EmanuelDecima/Fuente-Variable-con-Microcontrolador-/Doc/Imagenes/PCB_Front.png

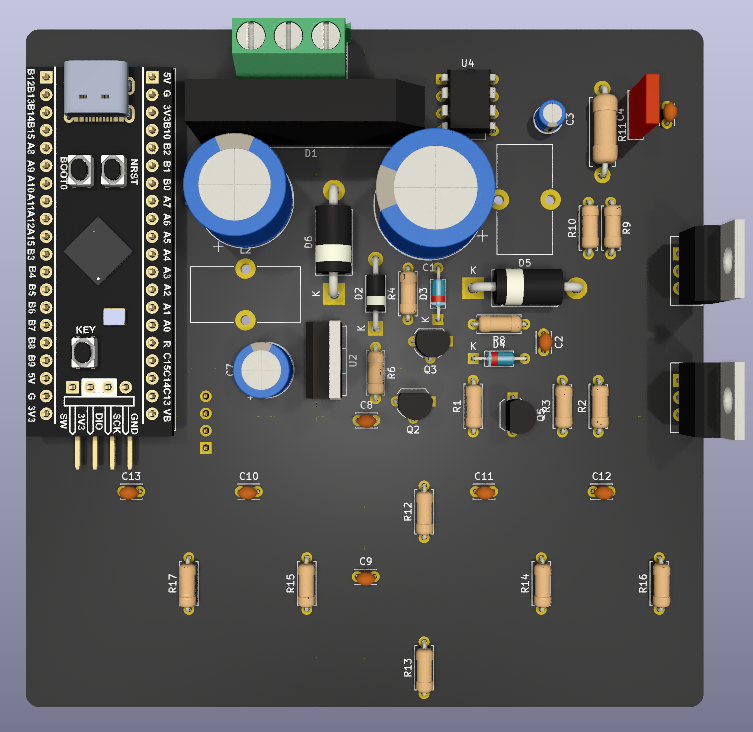
Doc/Imagenes/PCB_Front.png
