EmanuelDecima/Fuente-Variable-con-Microcontrolador-/Doc/Imagenes/PCB_Back.png

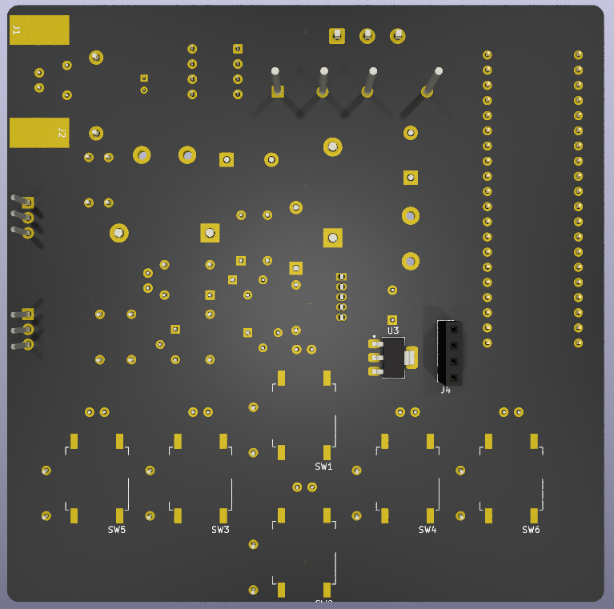
Doc/Imagenes/PCB_Back.png
