EmanuelDecima/Fuente-Variable-con-Microcontrolador-/Doc/Esquemas/FusibleElectronico-S-valores.pdf

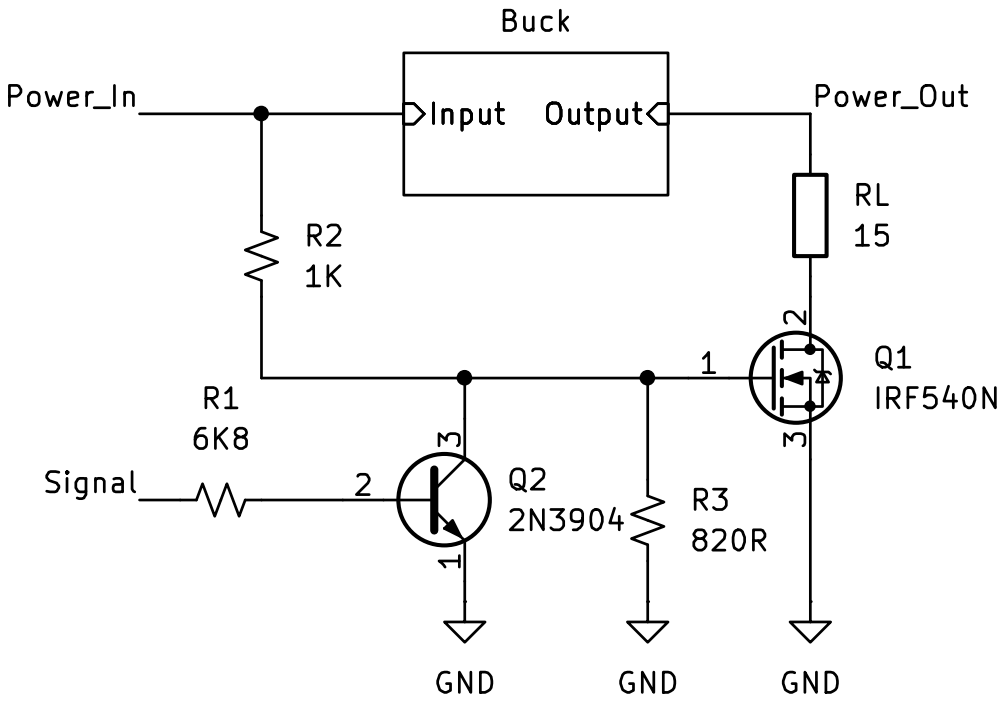
[picture p7: page 1]

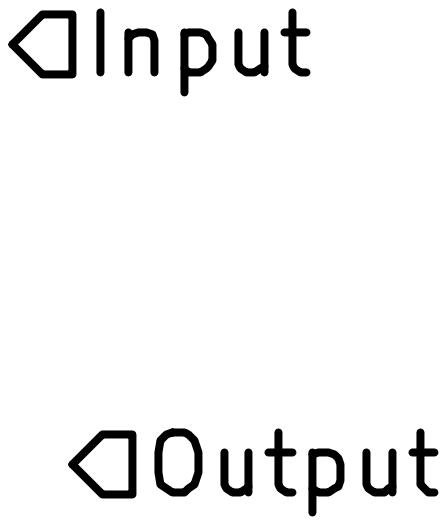
[picture p8: page 2]
