EmanuelDecima/Fuente-Variable-con-Microcontrolador-/Doc/Esquemas/Esquematico.pdf

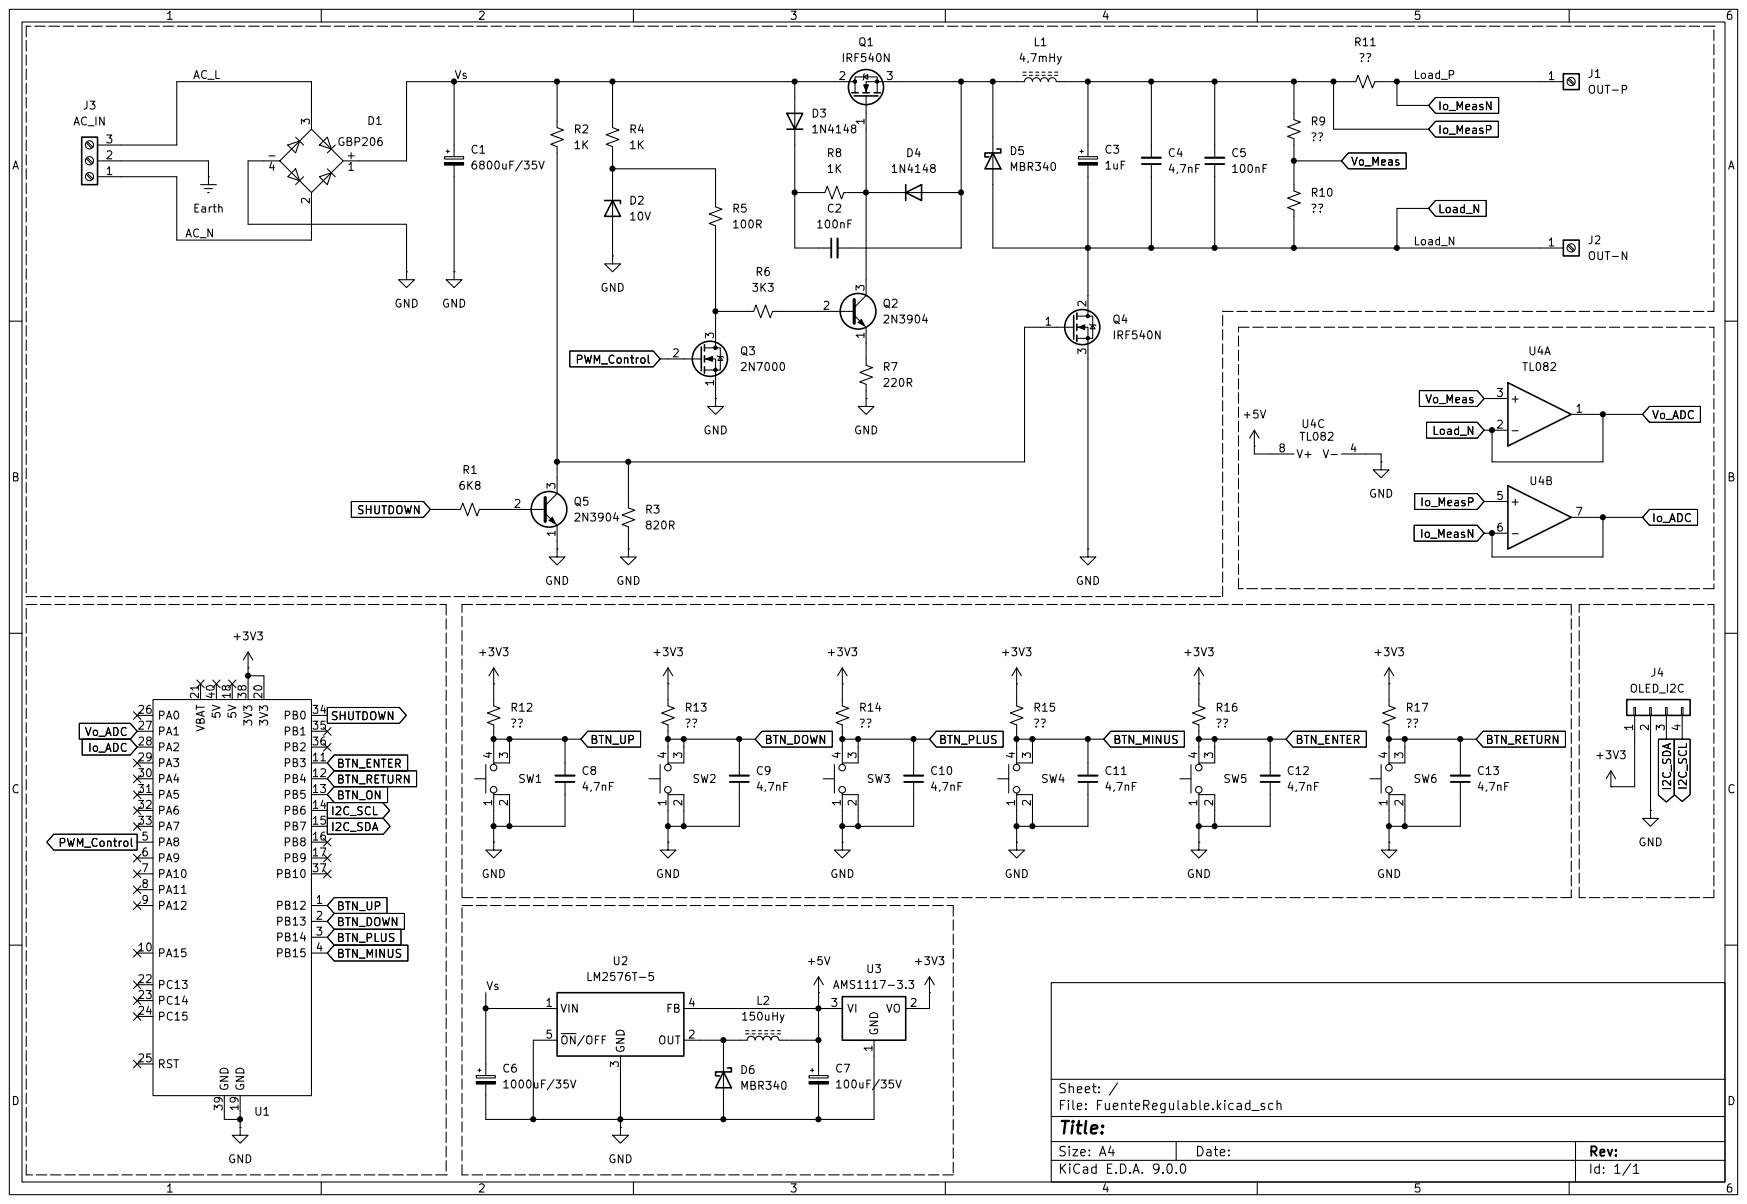
[picture p9: page 1]
