EmanuelDecima/Fuente-Variable-con-Microcontrolador-/Doc/Esquemas/EsquematicoV2.pdf

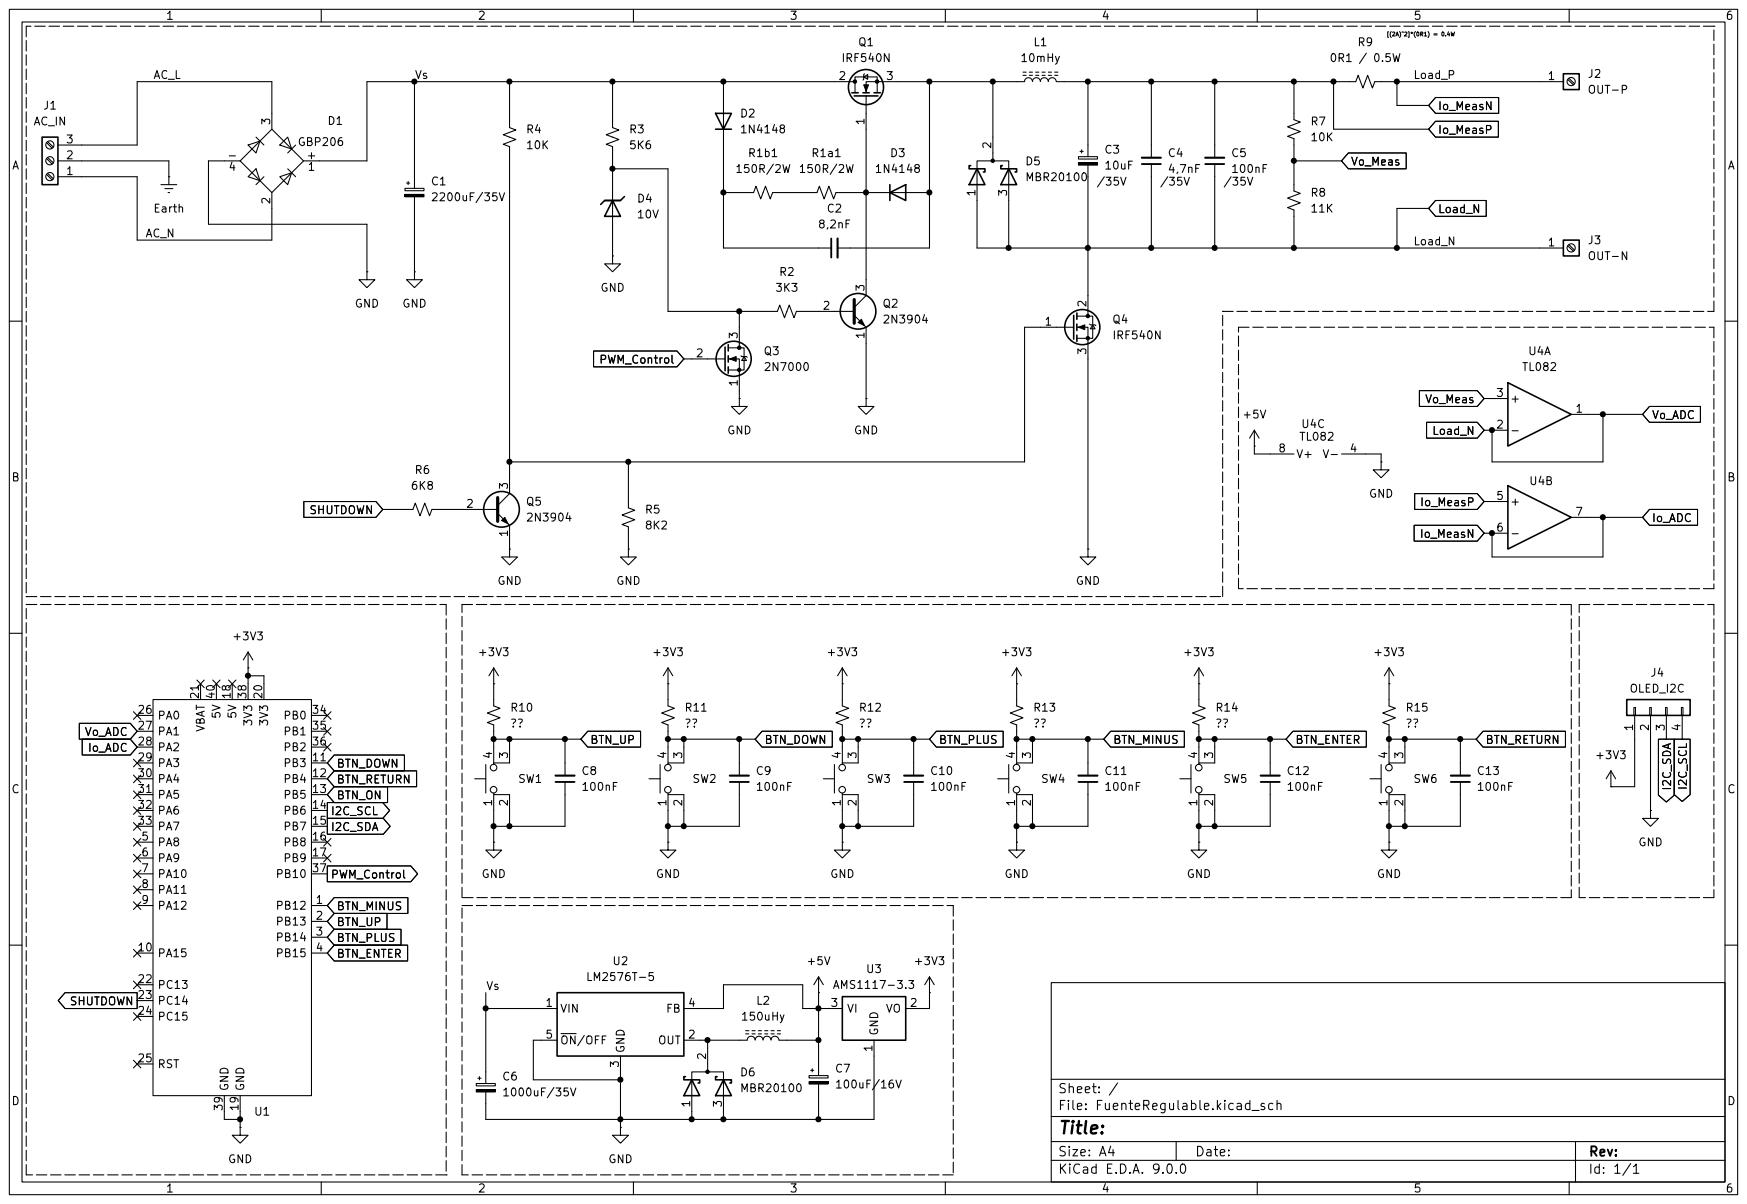
[picture p10: page 1]
