EmanuelDecima/Fuente-Variable-con-Microcontrolador-/Simulaciones/FusibleElectronico.asc

M1: nmos; AON6162
M2: nmos; 2N7002
R1: res; 6.8k
R2: res; 10k
R3: res; 8.2k
RL: res; 15
V1: voltage; SINE(31.84 3.18 100)
V2: voltage; PULSE(0 3.3 50m 1n 1n 100m 200m)
Named nets: 0
.tran 1
