EmanuelDecima/Fuente-Variable-con-Microcontrolador-/Simulaciones/PuenteDiodos.asc

C1: cap; 6800µ
D1: diode
D2: diode
D3: diode
D4: diode
RL: res; 16.92
V1: signal; SINE(0 33.84 50)
V2: voltage; 2
Named nets: 0, Salida
.tran 0 100m 10m
