EmanuelDecima/Fuente-Variable-con-Microcontrolador-/FuenteRegulable/FuenteRegulable.kicad_pcb

## KiCad design FuenteRegulable/FuenteRegulable.kicad_pcb (2025-11-13)

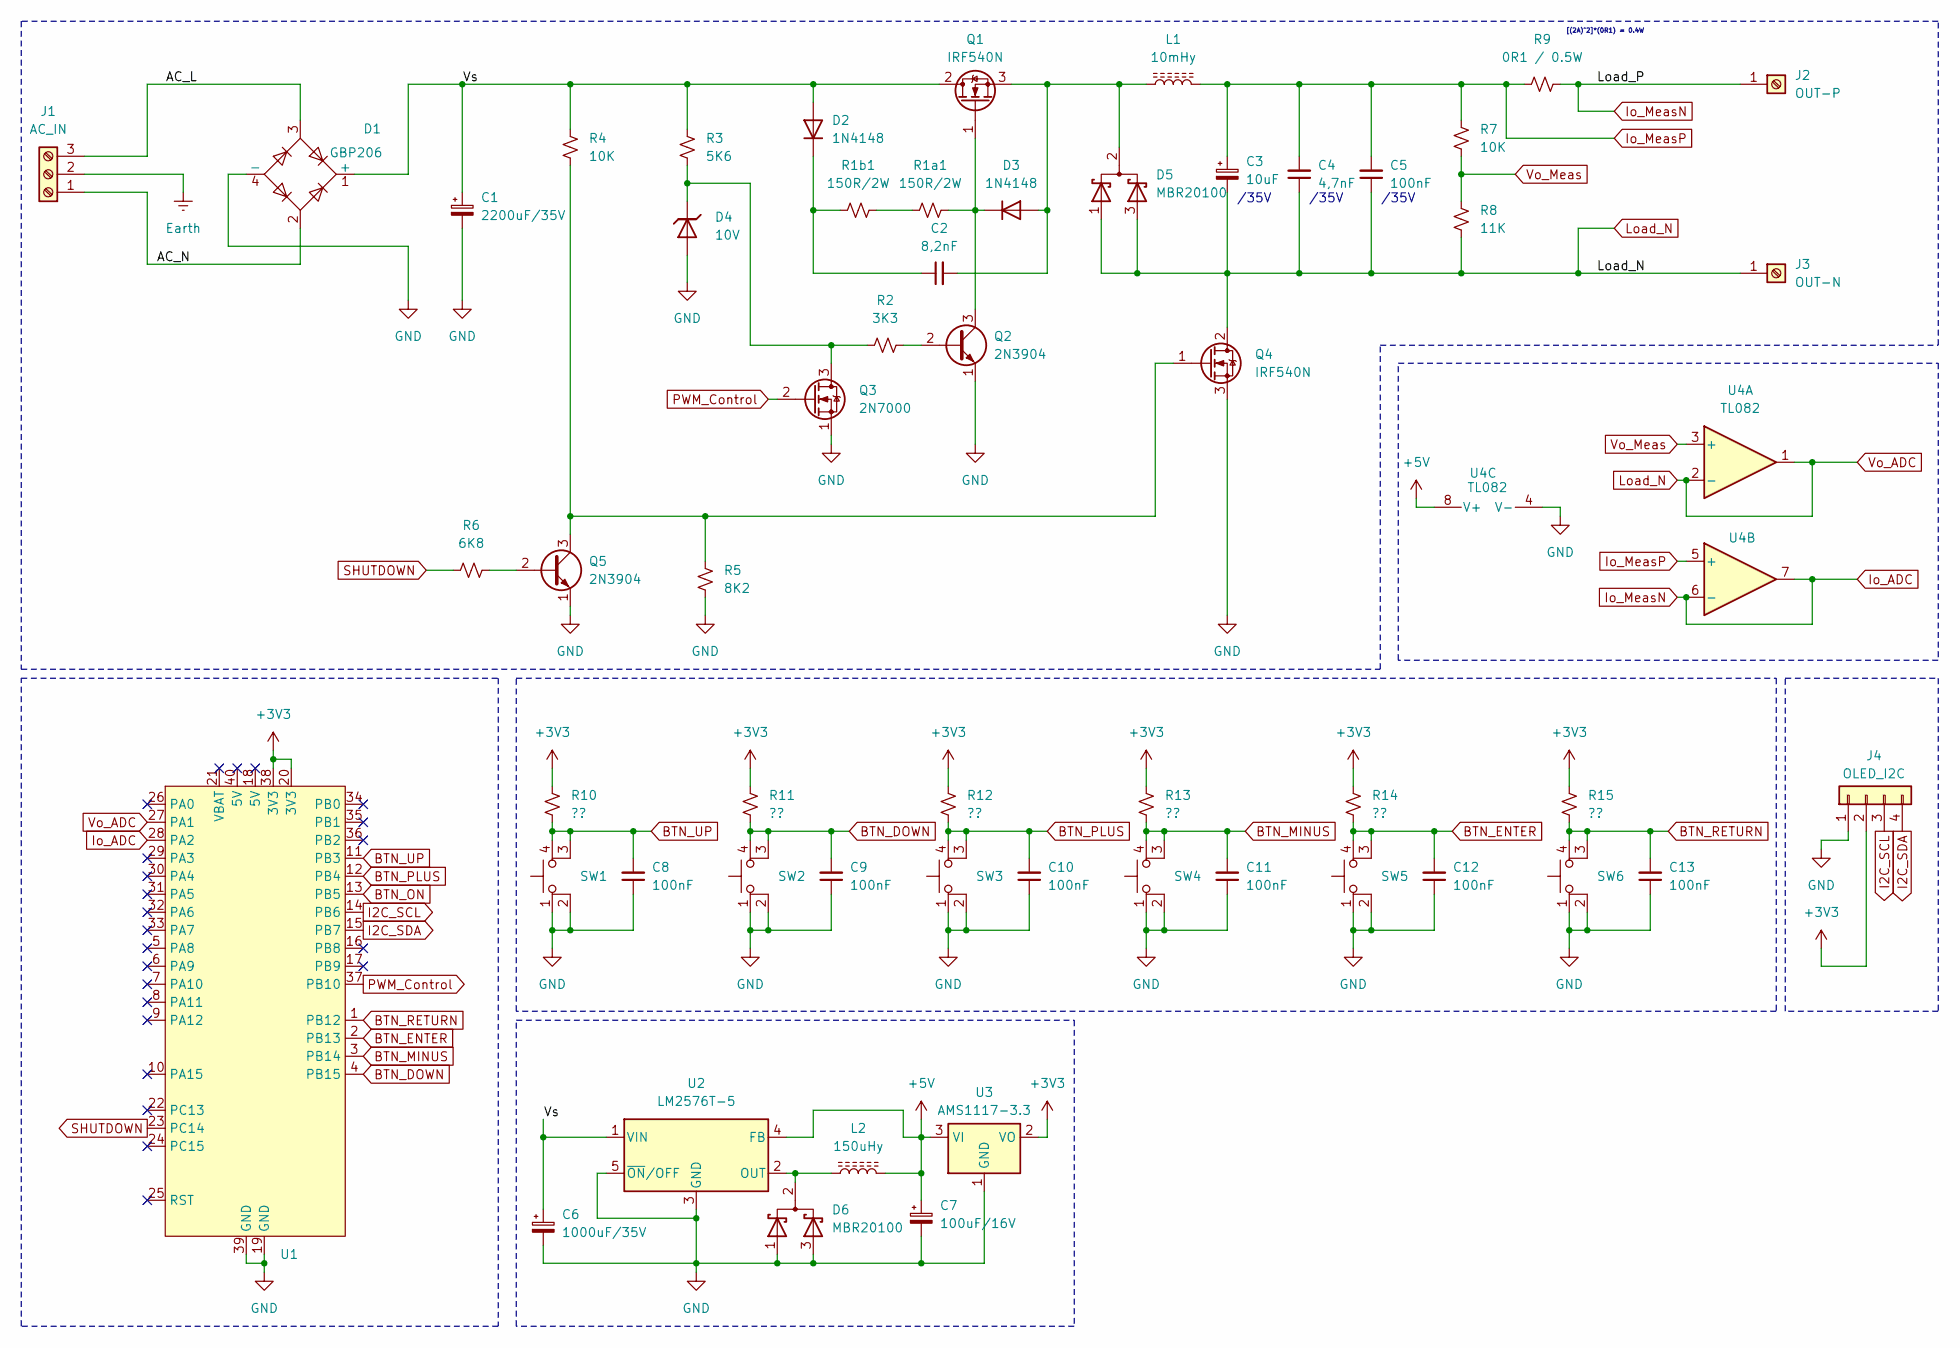
[picture p11: schematic FuenteRegulable.kicad_sch]

Parts:
C1: 2200uF/35V; CP_Radial_D16.0mm_P7.50mm
C2: 8,2nF; C_Disc_D3.0mm_W2.0mm_P2.50mm
C3: 10uF; CP_Radial_D4.0mm_P2.00mm
C4: 4,7nF; C_Rect_L7.0mm_W2.0mm_P5.00mm
C5, C8, C9, C10, C11, C12, C13: 100nF; C_Disc_D3.0mm_W2.0mm_P2.50mm
C6: 1000uF/35V; CP_Radial_D14.0mm_P7.50mm
C7: 100uF/16V; CP_Radial_D8.0mm_P5.00mm
D1: GBP206; Diode_Bridge_32.0x5.6x17.0mm_P10.0mm_P7.5mm
D2, D3: 1N4148; D_DO-35_SOD27_P7.62mm_Horizontal
D4: 10V; D_DO-41_SOD81_P10.16mm_Horizontal
D5, D6: MBR20100; TO-220-3_Horizontal_TabDown
J1: AC_IN; TerminalBlock_Phoenix_MKDS-1,5-3-5.08_1x03_P5.08mm_Horizont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
J2: OUT-P; SolderWirePad_1x01_SMD_5x10mm
J3: OUT-N; SolderWirePad_1x01_SMD_5x10mm
J4: OLED_I2C; PinSocket_1x04_P2.54mm_Vertical
L1: 10mHy; L_Toroid_Vertical_L16.0mm_W8.0mm_P7.62mm
L2: 150uHy; L_Toroid_Vertical_L16.0mm_W8.0mm_P7.62mm
Q1, Q4: IRF540N; TO-220-3_Vertical
Q2, Q5: 2N3904; TO-92_Wide
Q3: 2N7000; TO-92_Wide
R1a1, R1b1: 150R/2W; R_Axial_DIN0614_L14.3mm_D5.7mm_P15.24mm_Horizontal
R2: 3K3; R_Axial_DIN0207_L6.3mm_D2.5mm_P7.62mm_Horizontal
R3: 5K6; R_Axial_DIN0207_L6.3mm_D2.5mm_P7.62mm_Horizontal
R4, R7: 10K; R_Axial_DIN0207_L6.3mm_D2.5mm_P7.62mm_Horizontal
R5: 8K2; R_Axial_DIN0207_L6.3mm_D2.5mm_P7.62mm_Horizontal
R6: 6K8; R_Axial_DIN0207_L6.3mm_D2.5mm_P7.62mm_Horizontal
R8: 11K; R_Axial_DIN0207_L6.3mm_D2.5mm_P7.62mm_Horizontal
R9: 0R1 / 0.5W; R_Axial_DIN0411_L9.9mm_D3.6mm_P12.70mm_Horizontal
R10, R11, R12, R13, R14, R15: ??; R_Axial_DIN0207_L6.3mm_D2.5mm_P7.62mm_Horizontal
SW1, SW2, SW3, SW4, SW5, SW6: SW_MEC_5E; SW_MEC_5GSH9
U1: STM32BlackPill
U2: LM2576T-5; TO-220-5_Vertical
U3: AMS1117-3.3; SOT-223-3_TabPin2
U4: TL082; DIP-8_W7.62mm

Connections:
+3V3: J4.2, R10.2, R11.2, R12.2, R13.2, R14.2, R15.2, U1.20 (3V3), U1.38 (3V3), U3.2 (VO)
+5V: C7.1, L2.2, U2.4 (FB), U3.3 (VI), U4.8 (V+)
/AC_L: D1.3, J1.3
/AC_N: D1.2, J1.1
/Vs: C1.1, C6.1, D1.1 (+), D2.2 (A), Q1.2 (D), R3.2, R4.2, U2.1 (VIN)
BTN_DOWN: C9.2, R11.1, SW2.3 (K), SW2.4 (A), U1.4 (PB15)
BTN_ENTER: C12.2, R14.1, SW5.3 (K), SW5.4 (A), U1.2 (PB13)
BTN_MINUS: C11.2, R13.1, SW4.3 (K), SW4.4 (A), U1.3 (PB14)
BTN_ON: U1.13 (PB5)
BTN_PLUS: C10.2, R12.1, SW3.3 (K), SW3.4 (A), U1.12 (PB4)
BTN_RETURN: C13.2, R15.1, SW6.3 (K), SW6.4 (A), U1.1 (PB12)
BTN_UP: C8.2, R10.1, SW1.3 (K), SW1.4 (A), U1.11 (PB3)
Earth: J1.2
GND: C1.2, C6.2, C7.2, C8.1, C9.1, C10.1, C11.1, C12.1, C13.1, D1.4 (-), D4.2 (A), D6.1 (A), D6.3 (A), J4.1, Q2.1 (E), Q3.1 (S), Q4.3 (S), Q5.1 (E), R5.1, SW1.1, SW1.2, SW2.1, SW2.2, SW3.1, SW3.2, SW4.1, SW4.2, SW5.1, SW5.2, SW6.1, SW6.2, U1.19 (GND), U1.39 (GND), U2.3 (GND), U2.5 (~ON/OFF), U3.1 (GND), U4.4 (V-)
I2C_SCL: J4.3, U1.14 (PB6)
I2C_SDA: J4.4, U1.15 (PB7)
Io_ADC: J2.1, R9.1, U1.28 (PA2), U4.6 (-), U4.7
Io_MeasP: C3.1, C4.2, C5.2, L1.2, R7.2, R9.2, U4.5 (+)
Load_N: C3.2, C4.1, C5.1, D5.1 (A), D5.3 (A), J3.1, Q4.2 (D), R8.1, U1.27 (PA1), U4.1, U4.2 (-)
unnamed: C2.1, D2.1 (K), R1b1.1
unnamed: C2.2, D3.2 (A), D5.2 (K), L1.1, Q1.3 (S)
unnamed: D3.1 (K), Q1.1 (G), Q2.3 (C), R1a1.2
unnamed: D4.1 (K), Q3.3 (D), R2.1, R3.1
unnamed: D6.2 (K), L2.1, U2.2 (OUT)
unnamed: Q2.2 (B), R2.2
unnamed: Q4.1 (G), Q5.3 (C), R4.1, R5.2
unnamed: Q5.2 (B), R6.2
unnamed: R1a1.1, R1b1.2
PWM_Control: Q3.2 (G), U1.37 (PB10)
SHUTDOWN: R6.1, U1.23 (PC14)
Vo_Meas: R7.1, R8.2, U4.3 (+)

Notes on the sheet:
/35V
[(2A)^2]*(0R1) = 0.4W

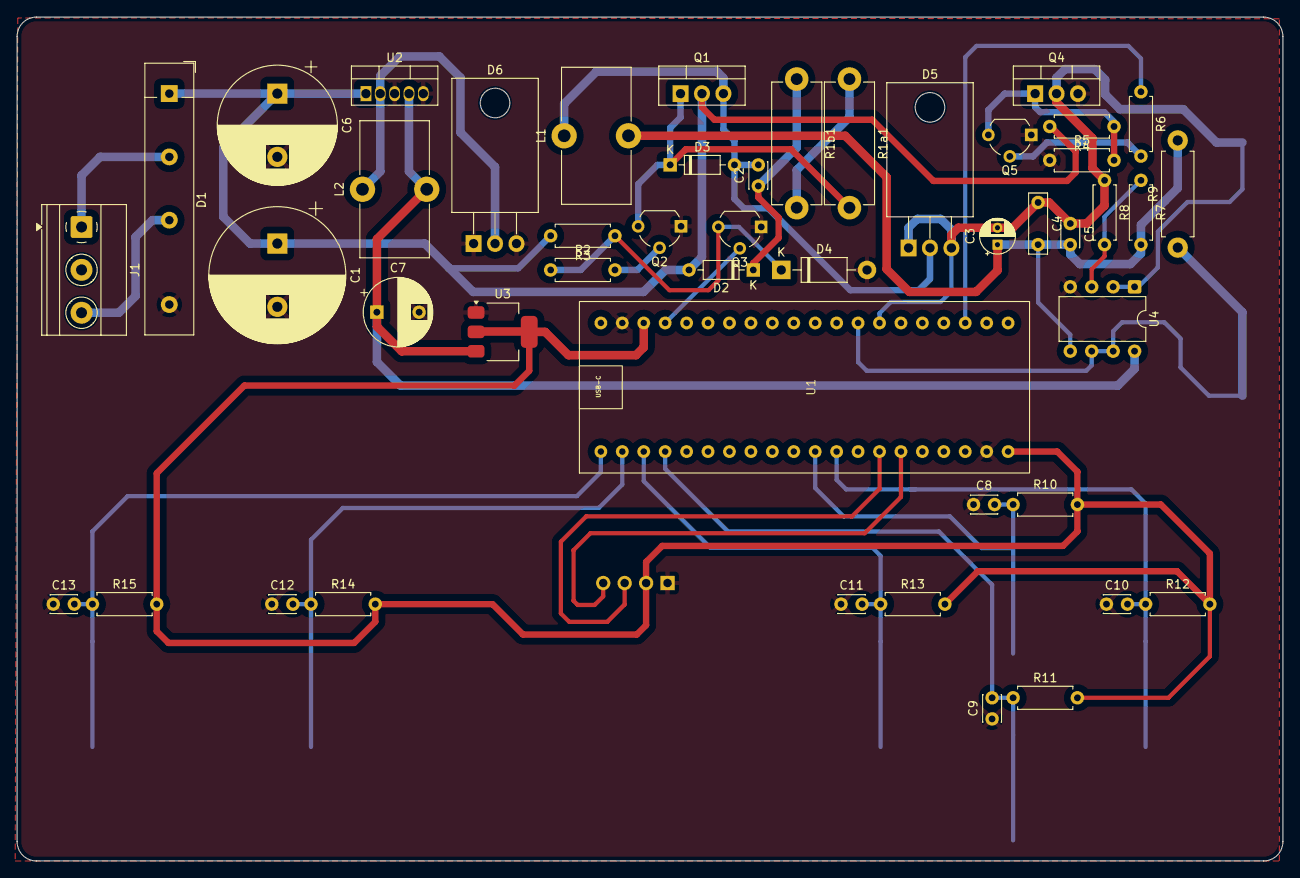
[picture p12: board FuenteRegulable.kicad_pcb from above]

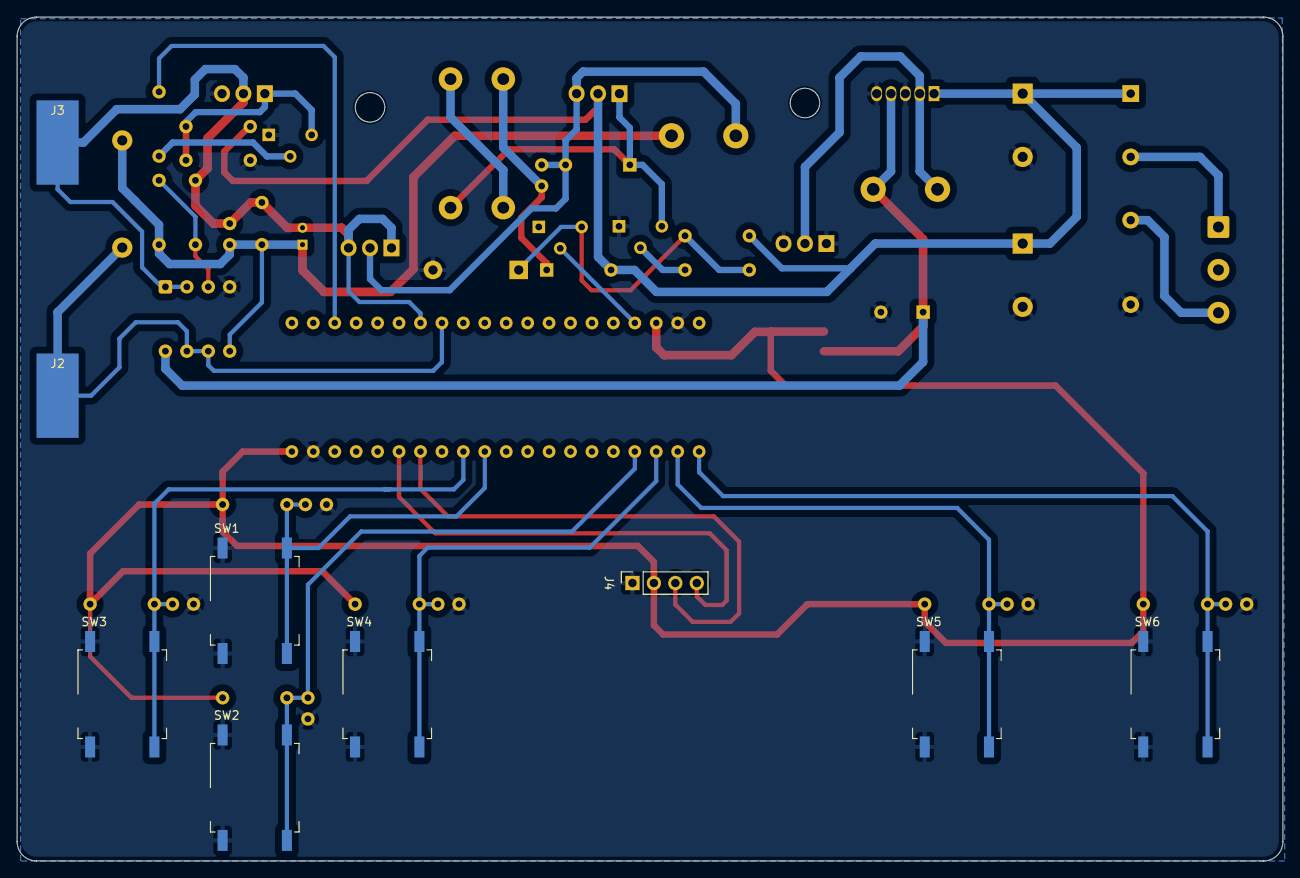
[picture p13: board FuenteRegulable.kicad_pcb from below]

Board: 2 copper layers, 150.0 x 100.0 mm, 56 parts (9 on the bottom side), 29 nets.
