EmanuelDecima/Fuente-Variable-con-Microcontrolador-/(commit log)

2025-11-07 Inicio de proyecto
    [FuenteRegulable.kicad_pcb, FuenteRegulable.kicad_sch]
2025-11-07 Simulacion de puente de diodos y filtro capacitivo principal
2025-11-07 Simulacion de fusible electronico
2025-11-12 Rediseño de fusible electronico-baja su consumo
2025-11-13 Diagrama esquematico terminado
    [FuenteRegulable.kicad_pcb, FuenteRegulable.kicad_sch]
2025-11-13 Comienzo a rutear PCB
    [FuenteRegulable.kicad_pcb, FuenteRegulable.kicad_sch]
2025-11-13 PCB Terminado
    [FuenteRegulable.kicad_pcb, FuenteRegulable.kicad_sch]
